mikey-7x/Project-Synapse-v1-official-Real-Time-Brainwave-Decoder-with-Android/assets/scientific-poster.pdf

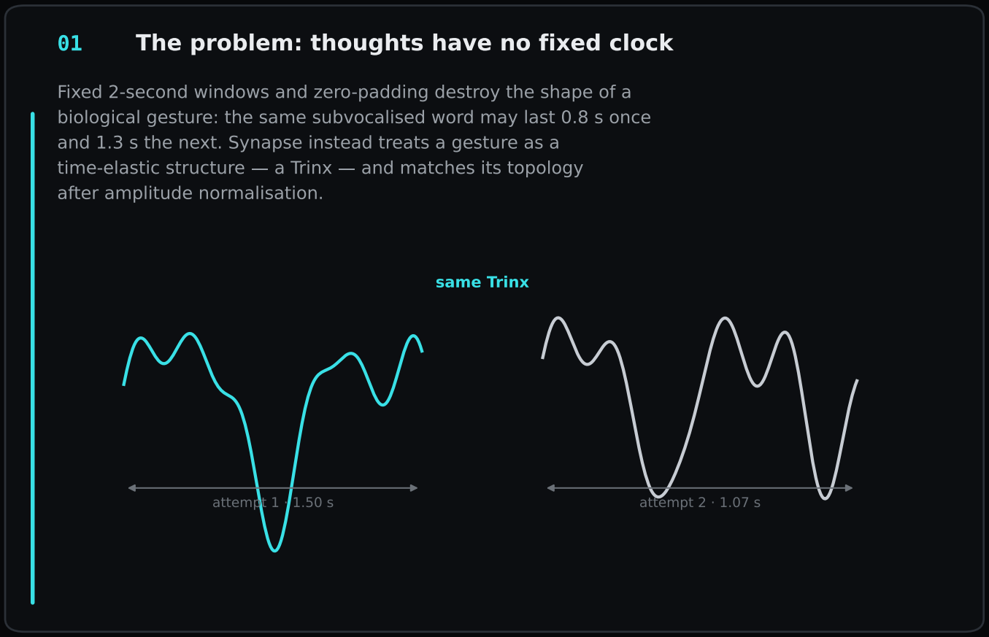
[picture p3: figure]
attempt 1 · 1.50 s; attempt 2 · 1.07 s; same Trinx; after amplitude normalisation.

## 01 The problem: thoughts have no fixed clock

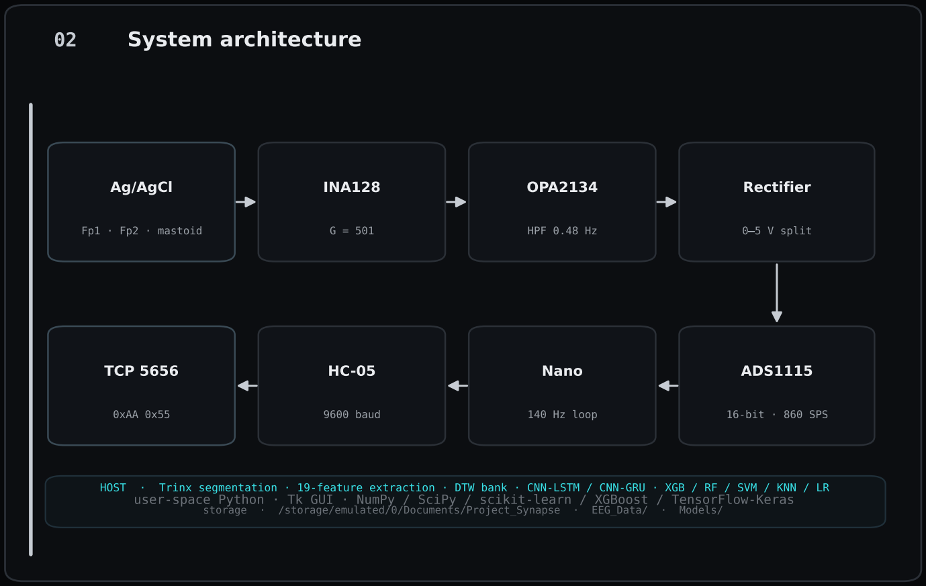
[picture p4: figure]
02 System architecture; Ag/AgCl; Fp1 · Fp2 · mastoid; INA128; OPA2134; HPF 0.48 Hz; Rectifier; 0 5 V split; ADS1115; 16-bit · 860 SPS; Nano; 140 Hz loop; 9600 baud; TCP 5656; 0xAA 0x55; storage; /storage/emulated/0/Documents/Project_Synapse; EEG_Data/; Models/

user-space Python · Tk GUI · NumPy / SciPy / scikit-learn / XGBoost / TensorFlow-Keras

HOST | · | Trinx segmentation · 19-feature extraction · DTW bank · CNN-LSTM / CNN-GRU · XGB / RF / SVM / KNN / LR

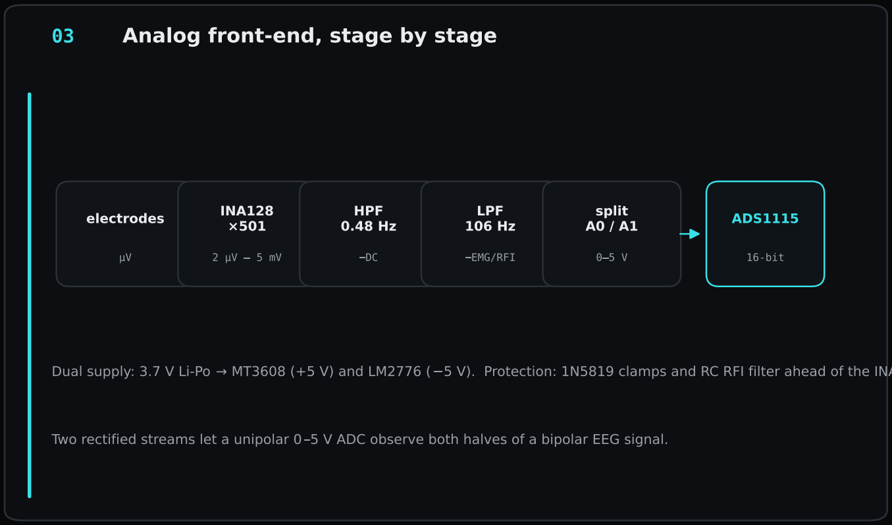
[picture p5: figure]
03 Analog front-end, stage by stage; electrodes; INA128 ×501; HPF 0.48 Hz; LPF 106 Hz; EMG/RFI; split A0 / A1; ADS1115; 16-bit

## 04 Binary link and timing budget

### 0xAA

sync

0x55

sync

### A0 hi

int16

### A0 lo

int16

### A1 hi

int16

### A1 lo

int16

6-byte frame · big-endian · differential channel = A0 | A1 (common-mode rejection in software)
sample rate | 140.0 Hz | micros()-paced 7 142 µs
ADC rate | 860 SPS | ADS1115 internal, oversampled
payload | 840 B/s | 140 frames × 6 bytes
link | 9 600 baud | HC-05 SPP | TCP bridge
UI buffer | 560 samples | 4.0 s rolling window

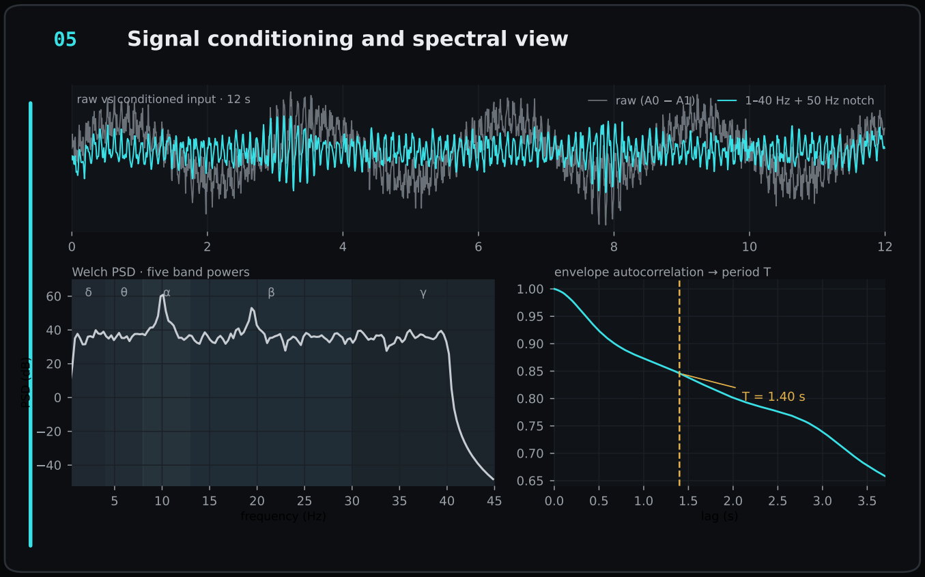
[picture p6: figure]
frequency (Hz); PSD (dB); Welch PSD · five band powers; lag (s); envelope autocorrelation; period T

## 05 Signal conditioning and spectral view

raw vs conditioned input · 12 s | raw (A0 | A1) | 1 40 Hz + 50 Hz notch

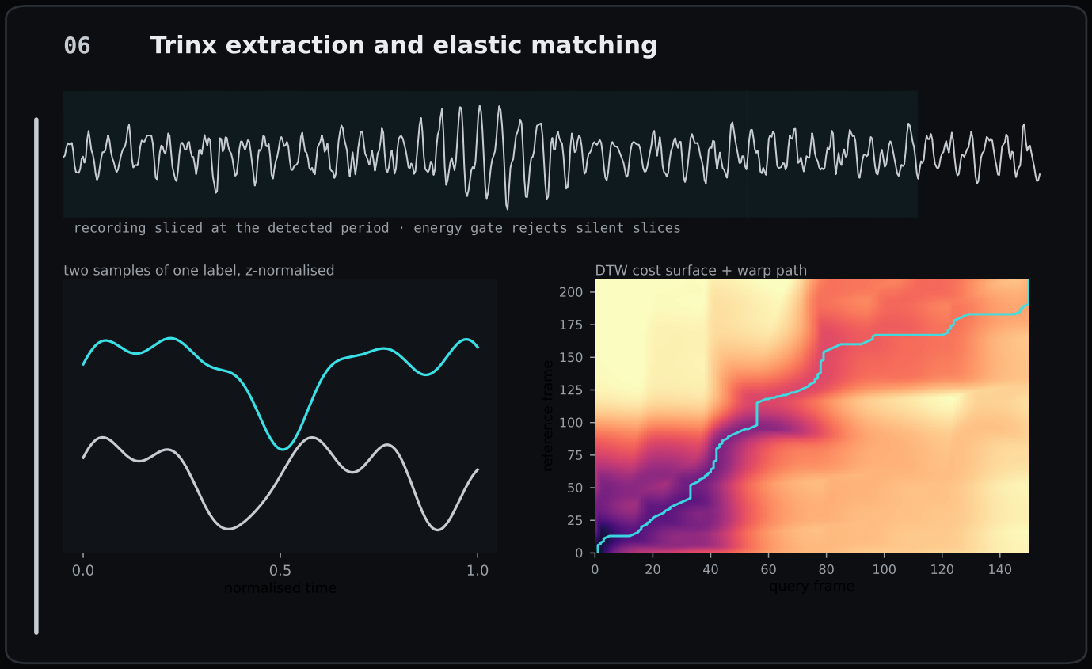
[picture p7: figure]
normalised time; two samples of one label, z-normalised; query frame; reference frame; DTW cost surface + warp path

## 06 Trinx extraction and elastic matching

recording sliced at the detected period · energy gate rejects silent slices

## 07 Decoder stack

Trinx-DTW | z-normalised DTW memory bank, nearest neighbour
CNN-LSTM | Conv1D(32) | BiLSTM(64) | LSTM(32) | softmax
CNN-GRU | Conv1D(32) | BiGRU(64) | GRU(32) | softmax
Classical | XGBoost · RandomForest · SVM-RBF · KNN · LogReg

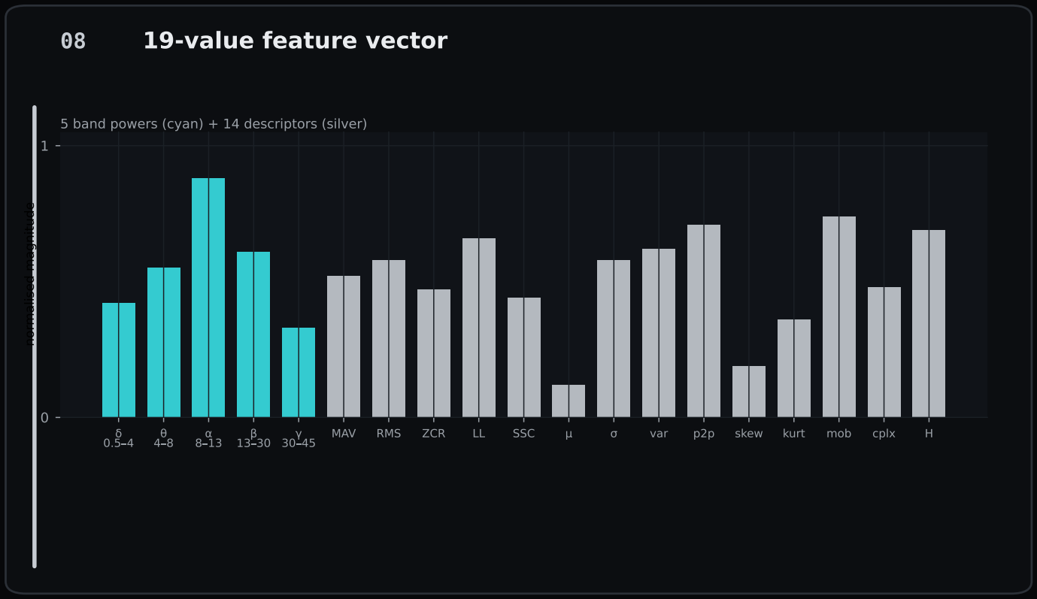
[picture p8: figure]
08 19-value feature vector; MAV; RMS; ZCR; SSC; var; skew; kurt; mob; cplx; normalised magnitude

5 band powers (cyan) + 14 descriptors (silver)

LIMITS & SAFETY | Not a medical device: no clinical validation, no regulatory certification, no diagnostic claim. Single subject-scale, single-channel data; no published accuracy is claimed here.
BATTERY POWER ONLY while electrodes touch a person | never mains-referenced equipment. Figures on this poster are synthetic illustrations of the pipeline, not measured results.

# PROJECT SYNAPSE v1

A single-channel EEG and subvocal-EMG acquisition instrument with variable-length ( Trinx ) gesture decoding

Analog front-end | 16-bit acquisition | Bluetooth transport | real-time desktop-class decoder | POWERED BY [mikey:hexoid-sys]
mikey-7x | github.com/mikey-7x/Project-Synapse-v1-official-Real-Time-Brainwave-Decoder-with-Android | Experimental research prototype · not a medical device

### Fixed 2-second windows and zero-padding destroy the shape of a biological gesture: the same subvocalised word may last 0.8 s once and 1.3 s the next. Synapse instead treats a gesture as a

time-elastic structure | a Trinx | and matches its topology
Dual supply: 3.7 V Li-Po | MT3608 (+5 V) and LM2776 ( 5 V). Protection: 1N5819 clamps and RC RFI filter ahead of the INA128.

Two rectified streams let a unipolar 0 5 V ADC observe both halves of a bipolar EEG signal.

Acceptance: a label is printed only at 90 % confidence; otherwise it is rejected. Confidence is a distance heuristic, not a calibrated probability.

Project Synapse v1 | Created by mikey-7x · strict personal & educational licence | POWERED BY [mikey:hexoid-sys]
github.com/mikey-7x | · | github.com/mikey-7x?tab=repositories | · | youtube.com/@mikey-7x | Copyright © 2026 mikey-7x. All rights reserved.
