mikey-7x/Project-Synapse-v1-official-Real-Time-Brainwave-Decoder-with-Android/SUPPORT.md

# Support

**POWERED BY [mikey:hexoid-sys]**

## Read first

| Document | Answers |
| --- | --- |
| [SAFETY.md](SAFETY.md) | Isolation, electrodes, consent, stop rules |
| [docs/ANDROID-SETUP.md](docs/ANDROID-SETUP.md) | Termux + PRoot Arch + Miniforge, X11 display |
| [docs/USAGE.md](docs/USAGE.md) | Connect, record, train, predict |
| [docs/TROUBLESHOOTING.md](docs/TROUBLESHOOTING.md) | Blank plots, no sync, training failures |
| [docs/LIMITATIONS.md](docs/LIMITATIONS.md) | What the system cannot do |

## Where to ask

- **Bugs:** use the bug-report issue form with the details it asks for.
- **Commercial, clinical or industrial licensing:** use the licence-request issue form.
- **Author:** https://github.com/mikey-7x · https://github.com/mikey-7x?tab=repositories

## Not provided

- Free commercial, clinical or deployment support — a signed written licence is required first.
- Medical interpretation of any recording, ever.
- Guarantees that a specific phone, Python version or TensorFlow build will work.
- Help bypassing the licence, the branding or the safety rules.
