mikey-7x/Project-Synapse-v1-official-Real-Time-Brainwave-Decoder-with-Android/pss2.pdf

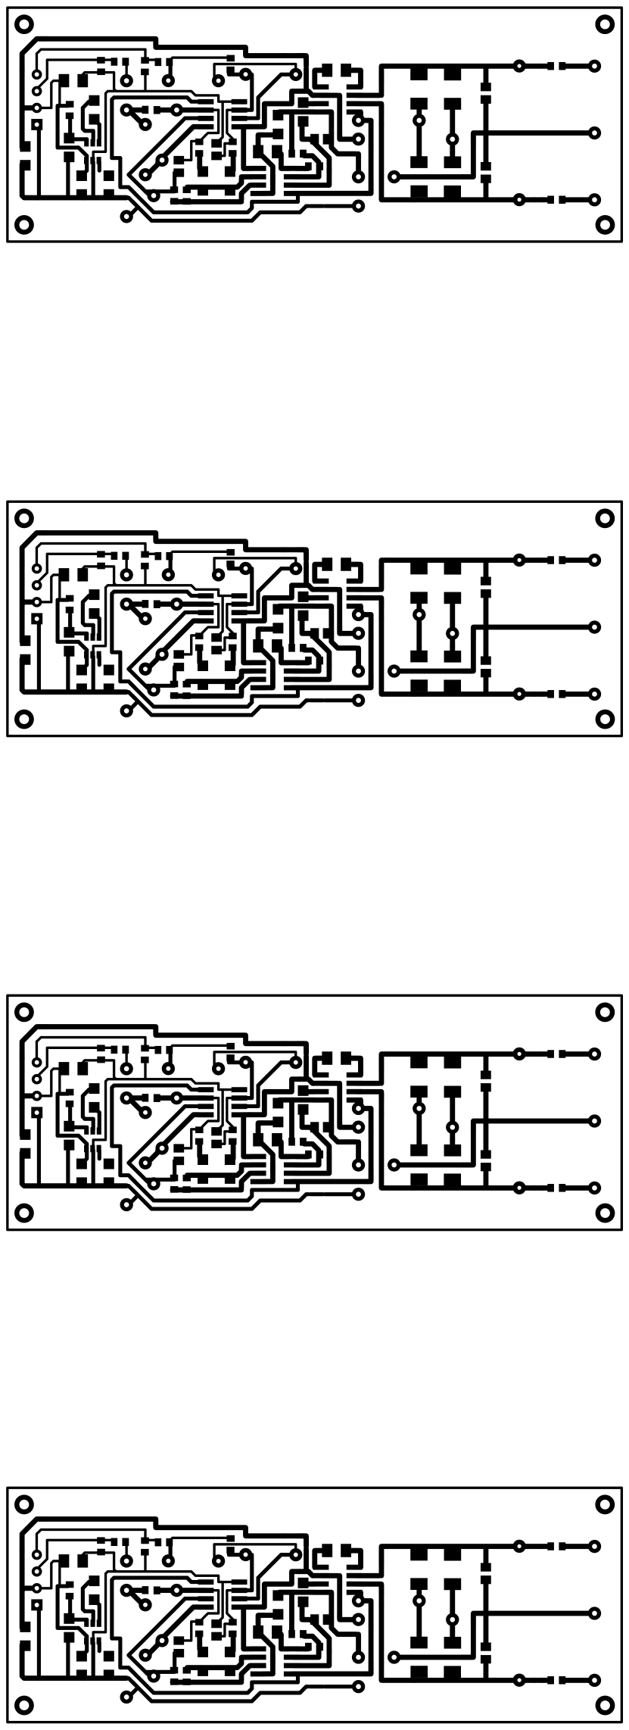
[picture p9: page 1]
