mikey-7x/Project-Synapse-v1-official-Real-Time-Brainwave-Decoder-with-Android/assets/github-social-preview.png

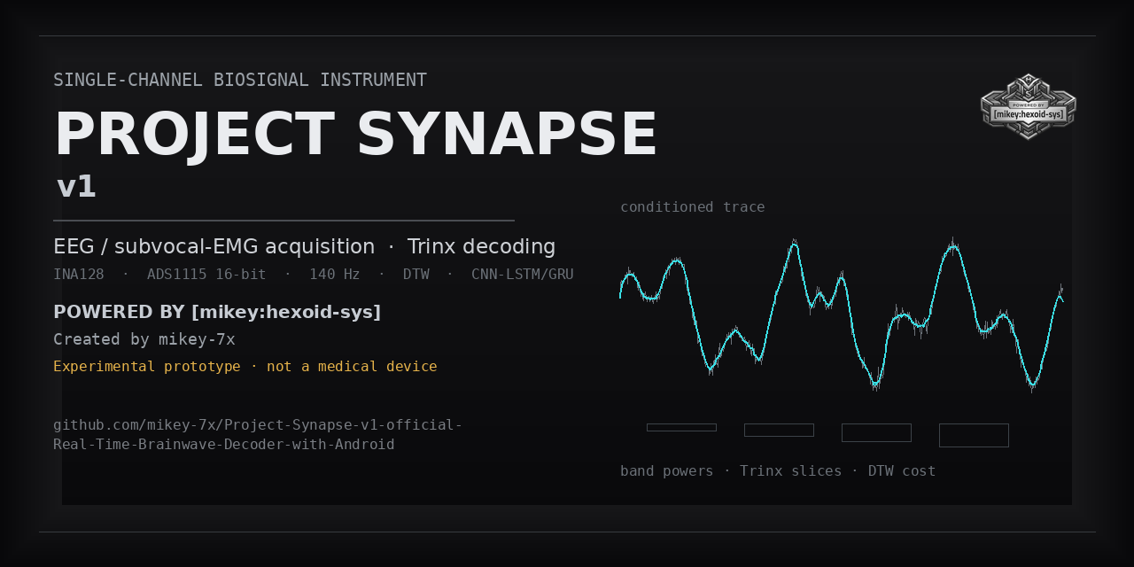
assets/github-social-preview.png
