mikey-7x/Project-Synapse-v1-official-Real-Time-Brainwave-Decoder-with-Android/PROJECT SYNAPSE.BMP

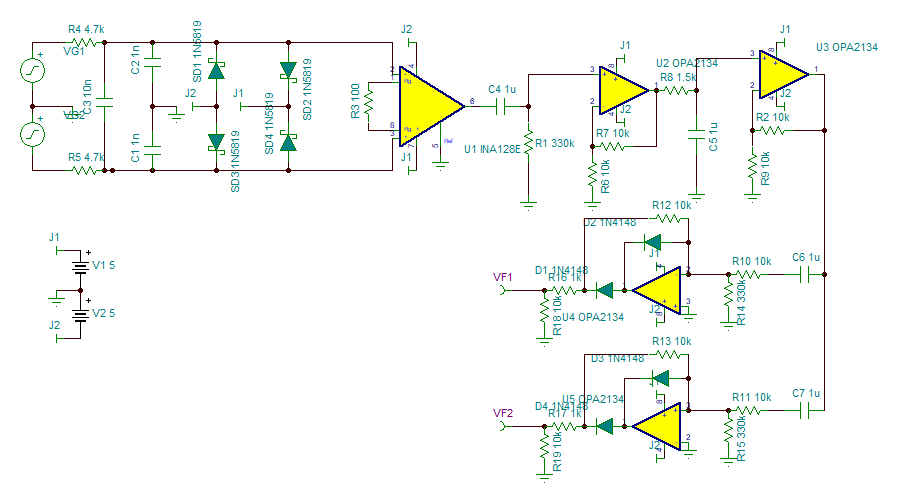
PROJECT SYNAPSE.BMP
