mikey-7x/Project-Synapse-v1-official-Real-Time-Brainwave-Decoder-with-Android/psl2.jpg

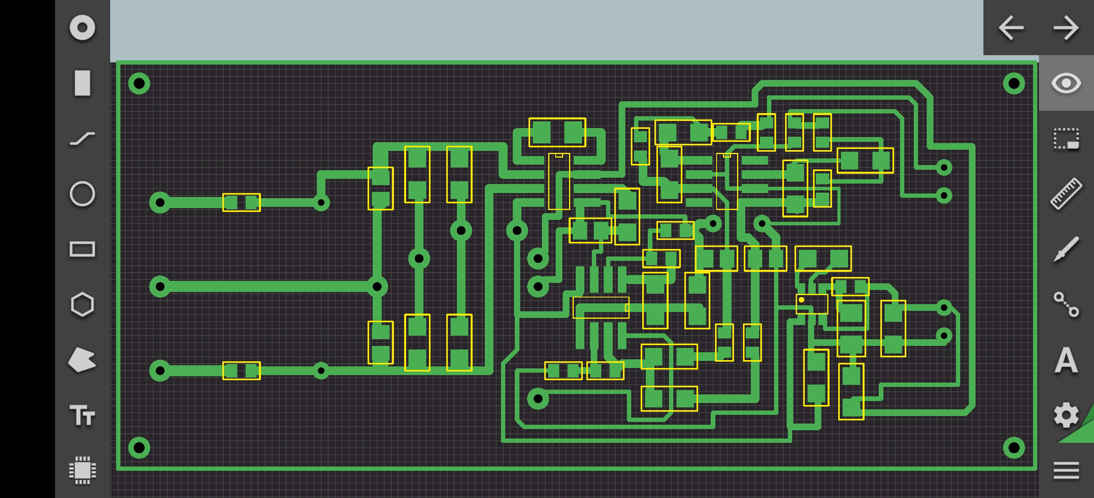
psl2.jpg
