mikey-7x/Project-Synapse-v1-official-Real-Time-Brainwave-Decoder-with-Android/psl4.jpg

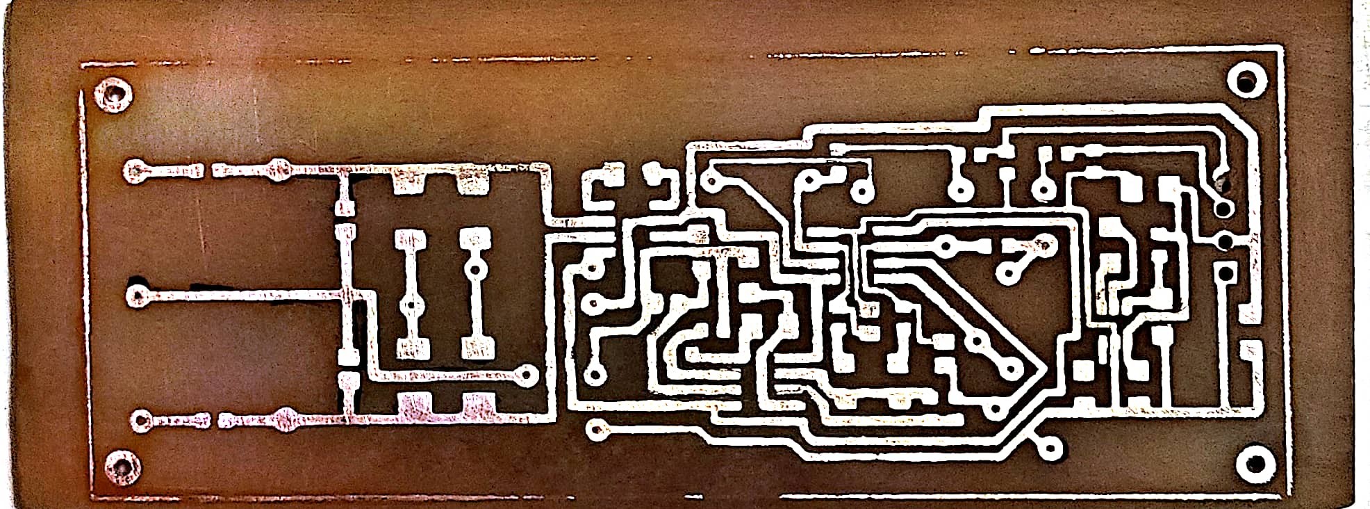
psl4.jpg
