mikey-7x/Project-Synapse-v1-official-Real-Time-Brainwave-Decoder-with-Android/psl5.jpg

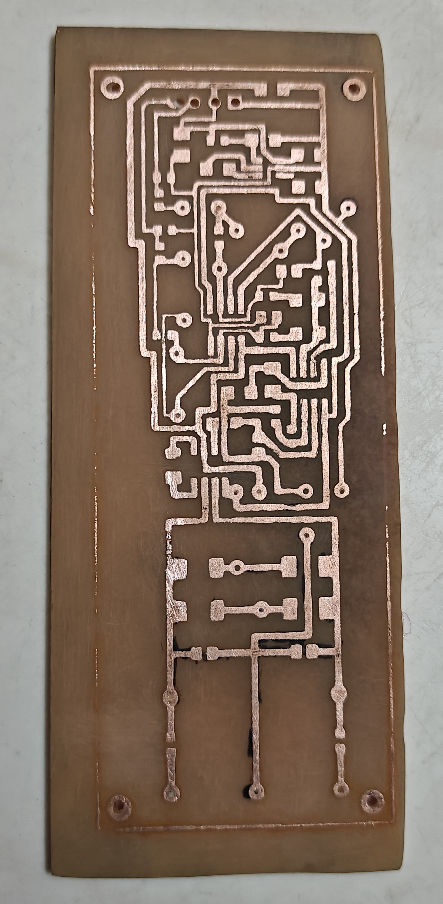
psl5.jpg
