mikey-7x/Project-Synapse-v1-official-Real-Time-Brainwave-Decoder-with-Android/pss.jpg

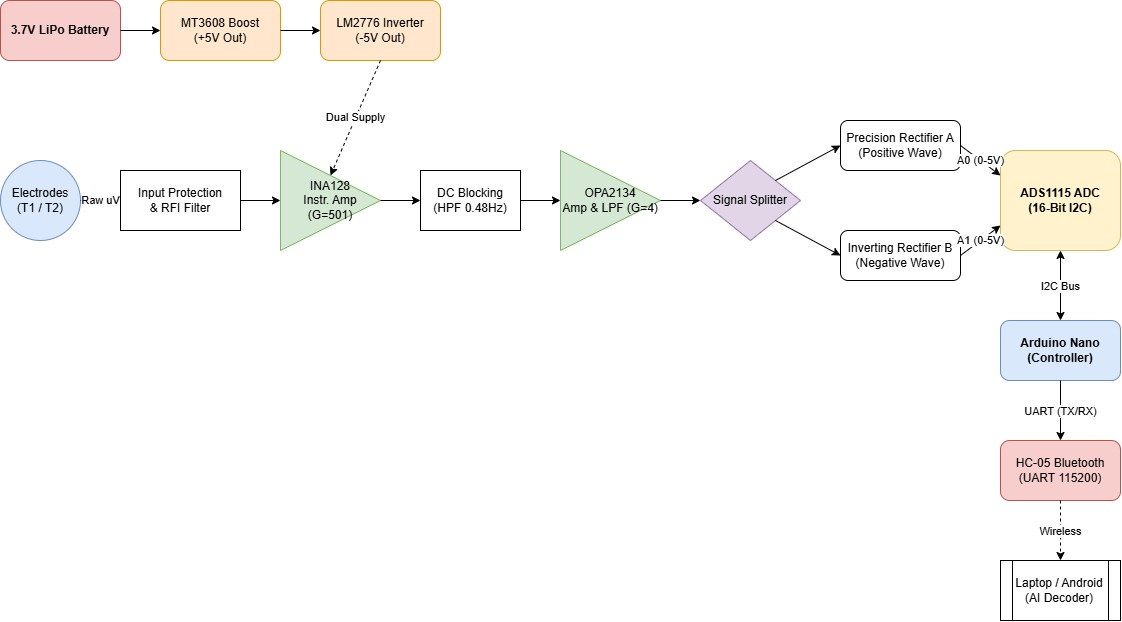
pss.jpg
