mikey-7x/Project-Synapse-v1-official-Real-Time-Brainwave-Decoder-with-Android/(notices)

Notices in the files:
README.md:
License: strict personal & educational
